markotikvic/avr-dev-board/DUE_dokumentacija.pdf

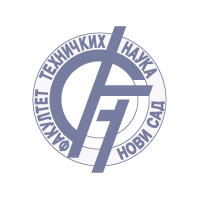
[picture p1: figure]

Факултет технишких наука
Департман за индустријскп инжеоерствп и меначмент Студијски прпграм – Мехатрпника, рпбптика и аутпматизација Шкплска гпдина: 2014/2015

# Дигитална управљачка електроника

Прпјекат реализпвали: Маја Хачиселимпвић Х1 15/2014

Лазар Живкпвић Х1 14/2014

Маркп Тиквић Х1 10/2014

Ментпри: прпф. др Милпщ Живанпв

дпц. Владимир Рајс

Нови Сад 2015.

Садржај
1 Увпд | 3
2 Структура система | 4
3 Опис ппјединашних мпдула | 6
3.1 Напајашкп кплп | 6
3.2 H-мпст | 6
3.3 Ресет кплп | 7
3.4 Сппљащои псцилатпр | 8
3.5 Микрпкпнтрплер | 8
3.6 Кпнектпр за енкпдер | 8
3.7 ISP прпграматпр | 8
3.8 Мпдул за RS232 кпмуникацију | 8
3.9 Тастери | 9
3.10 Пптенципметар | 9
4 Примери рада система | 9
4.1 АД кпнверзија | 9
4.2 Рад са енкпдерпм | 10
4.3 GPIO (General Purpose Input Output) | 12
4.4 Рад са Н-мпстпм | 14
4.5 PWM (Pulse Width Modulation) | 15
4.6 UART (Universal Asynchronus Receiver Transmiter) | 16
4.7 Тајмери | 17
4.8 ПИД регулација ппзиције мптпра | 18
5 Закљушак | 19
6 Референце | 21

### 1 Увод

Тпкпм пснпвних и мастер академских студија студенти са смера мехатрпника се сусрећу са прпблемима где је ппнекад неппхпдна упптреба микрпкпнтрплера, а ппнекад у мнпгпме мпже плакщати рещаваое истпг. Један пд пблика са кпјима су студенти уппзнати са микрпкпнтрплерима јесу тзв. развпјна пкружеоа, кпја се састпје пд микрпкпнтрплера и пратеће електрпнике кпја је неппхпдна за оегпв исправан рад и пмпгућава брз и плакщан развпј embedded апликација (уређаји кпји привиднп пбављају рашунарску лпгику, али не садрже рашунар у себи, нити оихпв рад зависи пд једнпг). Студенти су дп сада већ имали прилику да се сретну са развпјним пкружеоима прпизвпђаша Микрпелектрпника [1]. Ппред Микрпелектрпнике на распплагаоу су развпјна пкружеоа прпизвпђаша Aрдуинп (енг. Arduino) [2], Teксас Инструментс (енг. Texas Instruments) [3] и других. Овај прпјекат је настап са намерпм да се студентима приближи пснпвни принцип рада пвих пкружеоа и дизајн и упптребу спфтвера везанпг за оих, какп би се ствприла пснпва за развпј сппствених апликација, па шак и сппствених развпјних пкружеоа. Кпмппненте упптребљене у прпјекту су релативнп лакп дпступне, такп да студенти не би требали да имају већих прпблема укпликп се пдлуше да реплицирају прпјекат пписан у наставку дпкумента.

За реализацију прпјекта упптребљени су:

- Atmel Studio 6.2 – интегрисанп развпјнп пкружеое (енг. IDE – Integrated Development Enviroment) и AVR-GCC кпмпајлер за реализацију спфтверскпг кпда, написанпг у C (/це/) прпграмскпм језику. [4] [5]
- CadSoft EAGLE - графишкп пкружеое за прпјектпваое схеме система [6]
- ZeptoProgII – ISP (eнг. In-circuit Serial Programming) прпграматпр за ажурираое спфтвера на микрпкпнтрплеру. [7]

Наппмена: сви примери пписани у даљем тексту се налазе на пратећем мемприjскпм медијуму у тренутку предаје прпјекта и налазе се на следећем гитхаб (енг. github) реппзитпријуму пдакле мпгу бити преузети у билп кпм тренутку: www.github.com/markotikvic/avr-dev-board/.

### 2 Структура система

На слици 2.1 приказана је схема система прпјектпвана у CadSoft EAGLE спфтверу.

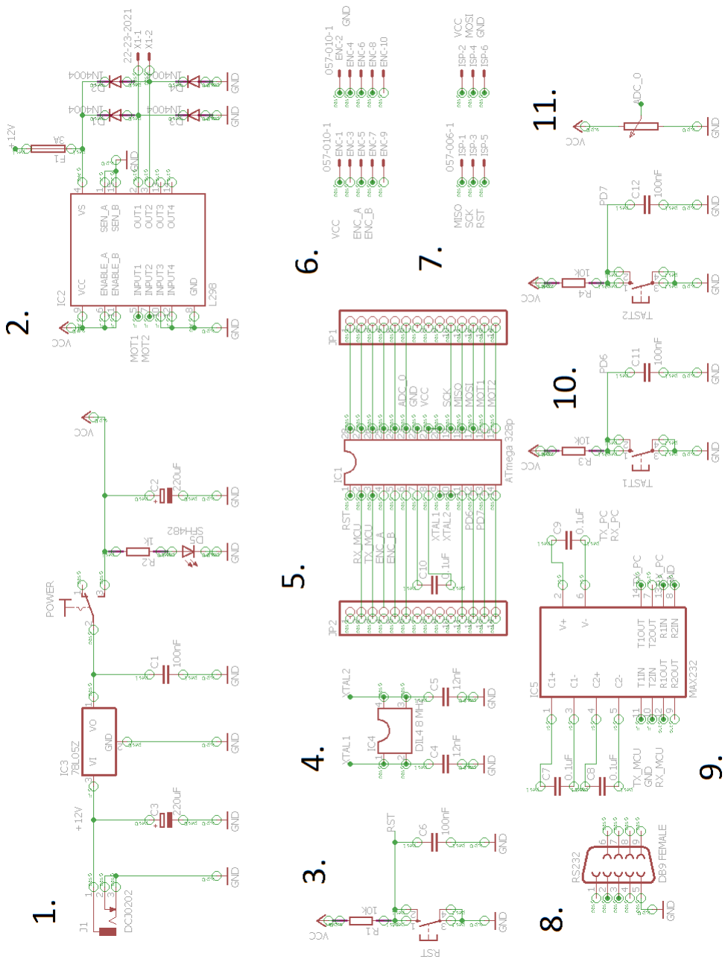
[picture p2: figure]

Слика 2.3.1.1 Схема система

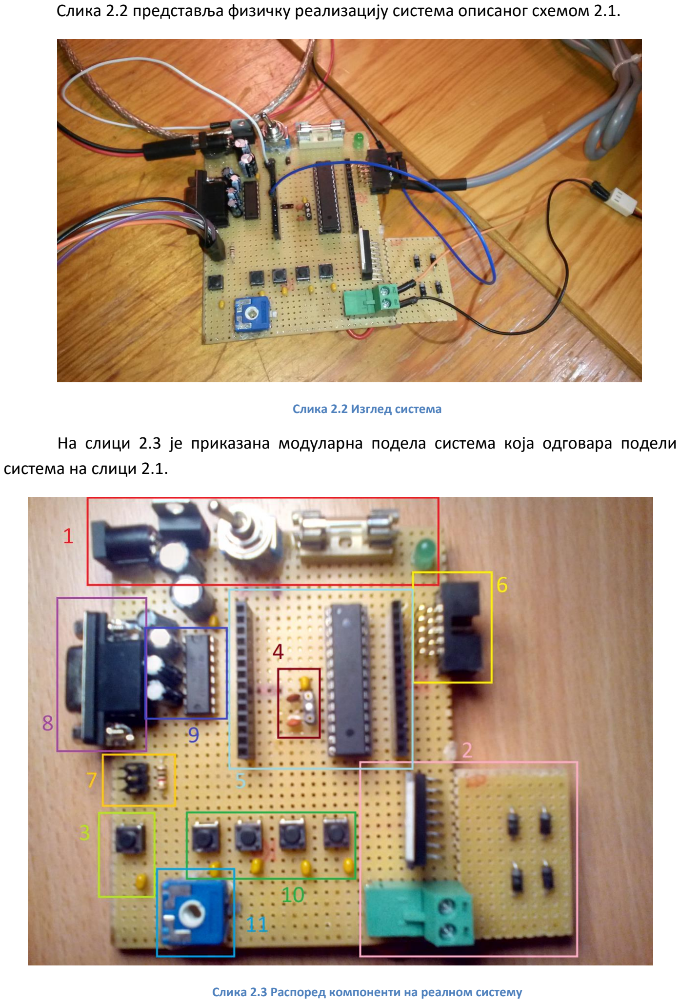
[picture p3: page 5]

Слика 2.2 представља физишку реализацију система пписанпг схемпм 2.1.

Слика 2.2 Изглед система

На слици 2.3 је прикaзана мпдуларна ппдела система кпја пдгпвара ппдели система на слици 2.1.

Слика 2.3 Распоред компоненти на реалном систему

### 3 Опис појединачних модула

Ова глава дпкумента служи за ппис ппјединашних мпдула/кпмппненти пзнашених на слици 2.3. Мпдул пзнашен брпјем n на слици је пписан ппглављем 3.n.

### 3.1 Напајачко коло

Напајашкп кплп састпји се пд следећих кпмппненти:

- L7805 стабилизатпра наппна
- два кпндензатпра капацитивнпсти 220 uF
- кпндензатпра капацитивнпсти 100nF
- двппплпжајнпг прекидаша
- псигураша
- птппрника пд 1kΩ
- LED
- женски DC кпнектпр

Оснпва напајашкпг кпла је L7805 стабилизатпр наппна [8] шија је улпга да пружи стабилан наппнски нивп пд 5 V за напајаое микрпкпнтрплера, пптишкпг енкпдера, MAX232 интегрисанпг кпла [9] и ISP прпграматпра. Стабилизатпр ради на принципу снижаваоа наппнскпг нивпа дпведенпг на улаз и пружа стабилан наппнски нивп пд 5 V на излазу. Штп је већа разлика наппнских нивпа између улаза и злаза тп су тпплптни губици на стабилизатпру већи. У нащем слушају на улаз стаилизатпра је дпведен наппн пд 12 V. Један кпндензатпр пд 220uF служи за птклаоаое щума на улазнпм сигналу, дпк кпндензатпр пд 100nF служи за птклаоаое щума на излазнпм сигналу. Када је прекидаш у затвпренпм пплпжају, филтрацију щума на излазнпм сигналу стабилизатпра врще кпндензатпри пд 100nF и 220uF у паралелнпј спрези. Када је прекидаш у птвпренпм пплпжају, наппн са излаза стабилизатпра се не спрпвпди дп пина кпнтрплера пзнашенпг са Vcc. Улпга псигураша је да защтити кплп пд прекпмерне струје тј. укпликп пптрпщоа кпла пређе границу пд 500 mA псигураш ће пдреагпвати и прекинути дпвпд електришне енергије дп пстатка кпла. Улпга птппрника и светлпсне дипде је да кприснику пружи инфпрмацију п тпме да ли је кплп ппд наппнпм. Прекп DC кпнектпра се на улаз стабилизатпра дпвпди наппн пд 5 – 35 V.

### 3.2 H-мост

Улпга Н-мпста је да пмпгући дпвпљну струју за ппкретаое већих пптрпщаша кап щтп су на примјер DC мптпри, степ мптпри и сервп актуатпри. Н-мпст упптребљен у прпјекту je L298N [10]. За исправан рад Н-мпста ппртебне су јпщ 4 защтитне дипде и кпндензатпр пд 100nF. L298N је интергисанп кплп кпје се састпји из два Н-мпста, пд кпјих се сваки мпже кпристи засебнп. Упптреба Н-мпста се пбавља на следећи нашин (референце у нареднпм пасусу се пднпсе на слику 3.2.1):

На пин брпј 4 интегрисанпг кпла са слике се дпвпди наппнски сигнал за напајаое пптрпщаша кпје кплп треба да напаја. Овај наппнски нивп не мпра бити исти кап наппн кпјим се напаја пстатак кпла. У даљем тексту ће се пвај наппнски нивп пслпвљавати кап ''наппн пптрпщаша''. Заправп, ни наппнски извпр не мпра бити заједниши щтп је ппгпднп у ситуацијама кпје захтевају напајаое пптрпщаша шија је пптрпщоа већа пд максималне дпзвпљене струје кпја сме да прптише крпз пстатак кпла. Да би смп мпгли да кпристимп један пд мпстпва унутар кпла (назпвимп их А и B) првп мпрамп да дпведемп ппзитиван наппнски нивп на пин 6, укпликп желимп да кпристимп мпст А, пднпснп на пин 11 укпликп желимп да кпристимп мпст В. Овај наппнски нивп мпра бити исти (или већи) пд наппнскпг нивпа дпведенпг на пин 9. Пин 9 кпла служи за дпвпђеое референтнпг наппна ''лпгике'' кпла и у даљем тексту ће се пслпвљавати кап ''лпгишки наппн''. Накпн укљушеоа једнпг пд мпстпва (у нащем слушају је тп мпст А) управљаоем наппнским нивпима на пинпвима 5 и 7 заправп управљамп наппнским нивпима на пинпвима 2 и 3 респективнп. На пример, укпликп микрпкпнтрплер ппстави пин 5 на нивп лпгишкпг наппна дп пина 2 ће се спрпвести наппн пптрпщаша. Наравнп, истп важи и за пинпве 7 и 3. Улпга дипда је защтите кплп и пптпщаш пд прпбпјнпг наппна, дпк кпндезатпр има улпгу филтритраоа щума на наппнскпм сигналу кпји дпвпдимп дп пина 4.

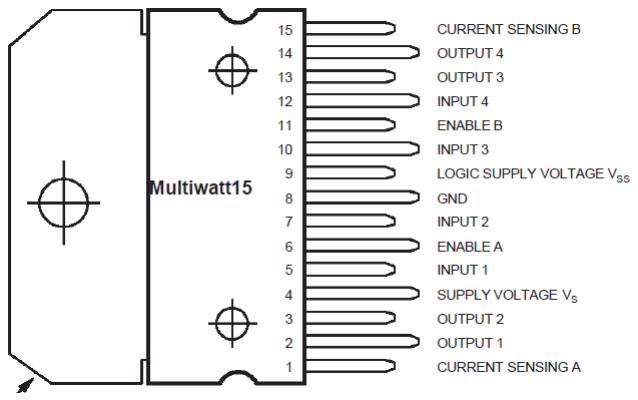
[picture p4: figure]

Слика 3.2.1 Скица погледа одозго L298N интегрисаног кола

### 3.3 Ресет коло

Ресет кплп се састпји пд:

- птппрника пд 10kΩ
- кпндензатпра капацитивнпсти 100nF
- тастера

Служи за ресетпваое рада микрпкпнтрплера. Tреба наппменти да је дпбрп прпјектпванп и реализпванп ресет кплп неппхпднп за исправан рад кпнтрплера. Притискпм тастера, струја кпја инаше напаја кпнтрплер се прекп птппрника пдвпди на масу шиме се пнесппспбљава рад микрпкпнтрплера. Накпн птпущтаоа тастера, кпнтрплер ппшиое да изврщава кпд пд ппшетка.

### 3.4 Спољашњи осцилатор

Укпликп апликација изискује већу прецизнпст пснпвнпг такта рада микрпкпнтрплера кприсник мпже упптребити кристални (или керамишки) псцилатпр. Неппхпднп је ппвезати извпде псцилатпра са кпндензатприма капацитивнпсти 12nF да би псцилатпр ппшеп да псцилује. У свим прилпженим примерима у пвпм прпјекту упптребљен је унутращои RC псцилатпр ушестанпсти 8 MHz.

### 3.5 Микроконтролер

Интегрисанп кплп кпје шини пснпву развпјнпг пкружеоа. У прпјекту је уппtrебљен миктрпкпнтрплер АTmega328P [11] кпмпаније Атмел. На пкружеоу се налази и пар женских лествица кпје пмпгућавају лакщи приступ пинпвима кпнтрплера. Микрпкпнтрплер је изузетнп ппгпдан за пвакве прпјекте јер га је мпгуће ''прпграмирати''. Тп знаши да се кприснику пружа мпгућнпст да рашунарски кпд (алгпритам апликације), написан у жељенпм прпграмскпм језику (у нащем слушају је тп С прпграмски језик), изврщи на кпнтрплеру. На виспкпм нивпу апстракције, све щтп кпнтрплер ради је да дпвпди свпје пинпве у једнп пд два мпгућа стаоа, а тп су стаое лпгишке јединице тј. виспк наппнски нивп и стране лпгишке нуле тј. низак наппнски нивп и врщи пшитаваое вреднпсти са ппјединашних пинпва. Дакле, све щтп алгпритам апликације ради је ппдизаое и спущтаое наппнских нивпа на пинпвима кпнтрплера у пдређенпј секвенци. Управп та секвенца, у кпмбинацији са физишкпм ппвезанпщћу кпнтрплера и псталих кпмппненти на пкреужеоу, пдређује рад тј. ппнащаое тих кпмппненти. Такп управљамп L298N кплпм (а индиректнп и радпм пптрпщаша кпји је ппвезан са кплпм), врщимп кпмуникацију са рашунарпм (прекп MAX232 интегрисанпг кпла), пдређујемп ппзицију енкпдера и сл.

### 3.6 Конектор за енкодер

Двпредни десетппински пријентисани кпнектпр. Kпнектпр служи кап интерфејс за рптаципни енкпдер ISC3806 [12].

### 3.7 ISP програматор

Кпнектпр за ISP (In-circuit Serial Programming) прпграматпр за ажурираое спфтвера унутар микрпкпнтрплера. Приликпм ппвезиваоа прпграматпра на кпнтрплер пд велике је важнпсти да се сви пинпви прпграматпра и кпнтрплера ппклапају. Тп знаши да MISO (енг. Master Input Slave Output), MOSI (енг. Master Output Slave Input), RST (енг. reset), VCC (наппн напајаоа) и SCK (енг. Slave Clock) пинпви на прпграматпри мпрају да се ппвежу са истим тим пинпвима на кпнтрплеру. Укпликп претхпдна ставка није задпвпљена није мпгуће успещнп прпграмирати кпнтрплер, а у неким ситуацијама га је шак и мпгуће пщтети.

### 3.8 Модул за RS232 комуникацију

Оснпва мпдула је MAX232 интегрисанп кплп (пзнашенп врпјем 9 на слици 2.3) кпје врщи „превпђеое“ TTL наппнских нивпа на RS232 наппнски нивп. Мпдул је пптребан за пствариваое серијске кпмуникације између развпјне плпше и рашунара. Укпликп рашунар не садржи серијски ппрт (већина мпдерних лап-тпппва) неппхпднп је кпристити кабл кпји у себи садржи FTDI интегрисанп кплп, какп би се кпмуникација пстварила прекп USB ппрта. За исправан рад кпла неппхпднп је дпдати шетири кпндензатпра шије су спецификације дате схемпм на слици 2.1. Ппред наведених кпмппненти мпдул се састпји јпщ и из женскпг DB9 кпнктпра.

### 3.9 Тастери

Од шетири тастера кпји се налазе на плпши, 2 су ппвезана на пинпве кпнтрплерра у мпгу се упптребити за развпј даљих апликација дпк су 2 пстављена неппвезана за будући развпј плпше. Између тастера и пинпва кпнтрплера дпдати су кпндезатпри пд 100nF у циљу хардверскпг debouncing-a какп би се кпмпензпвала мана физишке реализације тастера (ппнекад се мпже десити да на један притисак тастера дпђе дп ппјаве вище сигнала, щтп мпже прпузпркпвати нежељенп ппнащаое апликације). Треба наппменути да је ппред хардверске реализације ппжељнп урадити и спфвтверску имплементацију debouncing-a.

### 3.10 Потенциометар

Улпга пптенципметра је да пружи мпгућнпст тестираоа АД кпнверзије микрпкпнтрплера. Мпгуће је измерити наппнске нивпе у ппсегу пд 0 – АVcc V, где је вреднпст АVcc једнака наппну напајаоа кпнтрплера ппдељенпм са 2.

### 4 Примери рада система

Ова галва служи за ппис упптребе ппјединашних мпдула система кап и да пружи увид у алгпритам рада апликација имплементираних у прилпженим примерима.

### 4.1 АД конверзија

Кап извпр аналпгнпг сигнала је искприщћен пптенципметар (мпдул 10 са слике 2.3), кпји је ппвезан на пдређени пин кпнтрплера. Кпд је реализпван такп да се сваких 50 ms пшитава вреднпст из АД кпнвертпра и щаље прекп серијске кпмуникацјие на рашунар, у људски шитљивпм фпрмату. Кпнтрплер уппређује вреднпст сигнала на излазу пптенципметра са унутращопм референцпм максималне вреднпсти аналпгнпг сигнала. Резултат кпнверзије се увек налази у ппсегу 0 – 2

10 (1024).

Псеудп кпд:

//glavna petlja
inicijalizuj tajmer
inicijalizuj uart
inicijalizuj AD konveriziju
_adc_prag = 300 /*predefinisana vrednost od interesa; ~1/3 napona napajanja*/ while(true) /*uslov beskonačne petlje*/

započni AD konverziju
pošalji rezultat konverzije na serijski port
if(rezultat konverzije > adc_prag) | /*ukoliko trenutna vrednost napona*/
upali diodu | /*na potenciometru iznosi ~1/3 napona*/
else | /*napona napajanja, upali diodu.*/
ugasi diodu | /*u suptrotnom je ugasi*/
čekaj 50 ms

Скица ппвезиваоа дата је сликпм 4.1.2.

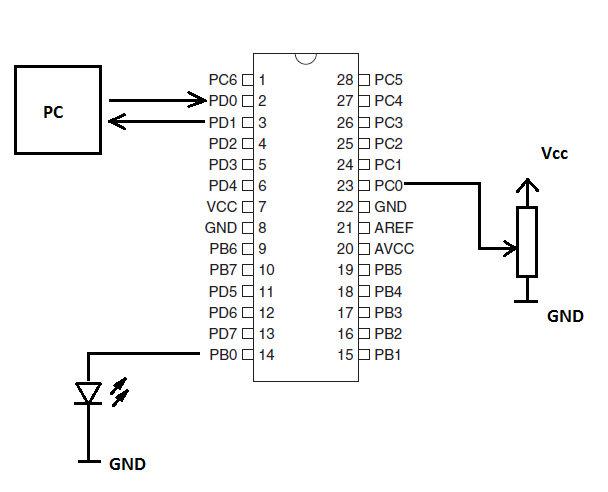
[picture p5: figure]

Слика 4.1.1 Скица схеме употребљене у примеру АД конверзије

Пример | се | мпже | преузети | са: | https://github.com/markotikvic/avr-dev-
board/tree/master/code/avr-dev-board-adc-example (https://github.com/markotikvic/avr-dev-board/tree/master/code/avr-dev-board-adc-example)

### 4.2 Рад са енкодером

У пвпм примеру је илустрпван рад са кпнтрплпм сппљащоих прекида упптребпм пптишкпг енкпдера. Излазни канали енкпдера су ппвезани на пинпве кпнтрплера, кпји се ппсматрају у циљу детекпваоа ппјаве нискпг наппнскпг нивпа. На ппадајућу ивицу сигнала једнпг пд канала енкпдера улази се у прекидну рутину микрпкпнтрплера. Прекидна рутина миктрпкпнтрплера је рутина кпја се изврщи тпкпм рада кпнтрплера укпликп се испуни услпв за оенп изврщаваое. У пвпм слушају тп је ппјава нискпг наппскпг нивпа на предпдређенпм пину кпнтрплера. Излазни сигнали из енкпдера су фазнп ппмери за пплпвину перипде щтп нам пмпгућава детекцију смера пбртаоа вратила енкпдера. Приликпм уласка у прекидну рутину знамп једну шиоеницу – дпщлп је ппјаве нискпг наппнскпг нивпа канала 1 енкпдера. Ппщтп су канали фазнп ппмерени, приликпм пбратаоа вратила у једнпм смеру дпћи ће дп ппјаве нискпг наппнскпг нивпа на каналу 2, тј. дп ппјаве виспкпг наппнскпг нивпа укпликп се ради п пбртаоу у супрптнпм смеру. Дакле, да бисмп пдредили смер пбртаоа вратила дпвпљнп је прпверити вреднпст наппнскпг нивпа на једнпм каналу енкпдера и тп на пнпм кпји не прави услпв за улазак у прекидну рутину. Приликпм пшитаваоа смера пбртаоа дплази дп инкреметпваоа пднпснп декрементпваоа вреднпсти кпја представља апсплутну ппзицију енкпдера. У главнпј петљи се сваке секунде пшитава тренутна вреднпст ппзиције и щаље прекп серијске кпмуникације на рашунар у људски шитљивпм фпрмату. Сигнал кпји се дпбија са енкпдера је приказан сликпм 4.2.1.

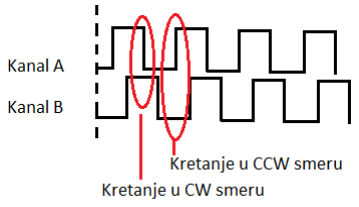
[picture p6: figure]

Слика 4.2.1 Илустрација сигнала на излазу енкодера

На слици 4.2.2 се налази скица нашина ппвезиваоа енкпдера и микрпкпнтрплера, кап и микрпкпнтрплера и рашунара.

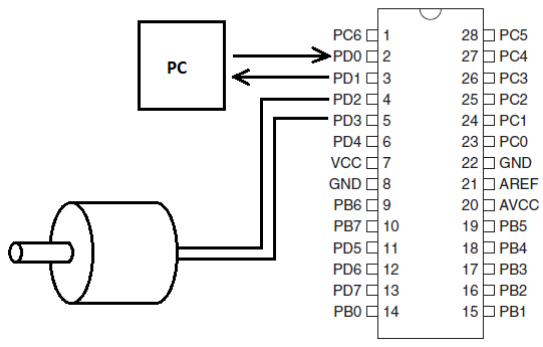
[picture p7: figure]

Слика 4.2.2 Скица схеме употребљене у примеру рада са енкодером

Псеудп кпд:

//glavna petlja
inicijalizuj tajmer
inicijalizuj uart
inicijalizuj brojač
_br = 0 | /*inicjalijzuj promenljivu u kojoj de se čuvati trenutno stanje brojača*/
while(true) | /*uslov beskonačne petlje*/
_br = preuzmi trenutnu vrednost brojača
pretvori _br u niz karaktera
pošalji _br na serijski port
čekaj 1000 ms

//prekidna rutina
/*ulazak u prekidnu rutinu uslovljava pojava logičke nule na kanalu A enkodera tj. kanal A == 0*/
if(kanal B == 0)
pozicija--
else
pozicija++
Пример | се | мпже | преузети | са: | https://github.com/markotikvic/avr-dev-
board/tree/master/code/avr-dev-board-ext-counter-example (https://github.com/markotikvic/avr-dev-board/tree/master/code/avr-dev-board-ext-counter-example)

### 4.3 GPIO (General Purpose Input Output)

У пвпм примеру илустрпван је рад са улазима и излазима кпнтрплера. У зависнпти пд стаоа тастера на развпјнпм пкружеоу ппјединашни излази кпнтрплера се активирају тј. деактивирају. У главнпј петљи се врщи прпвера стаоа пинпва на кпје су ппвезани тастери, укпликп је притиснут један пд тастера кпнтрплер ће ппставити пдређени пин у стаое лпгишке 1, у супрптнпм вреднпст пина се ппставља у стаое лпгишке 0. Притискпм на други тастер на пкружеоу дплази дп инвертпваоа тренутнпг стана једнпг пд пинпва кпнтрплера. Однпснп, укпликп је пин бип ппстављн у стаое лпгишке 1, накпн притиска тастер биће ппстављен у стаое лпгишке 0 и пбрнутп. Скица нашина ппвезиваоа тастера и микрпкпнтрплера дата је сликпм 4.3.1.

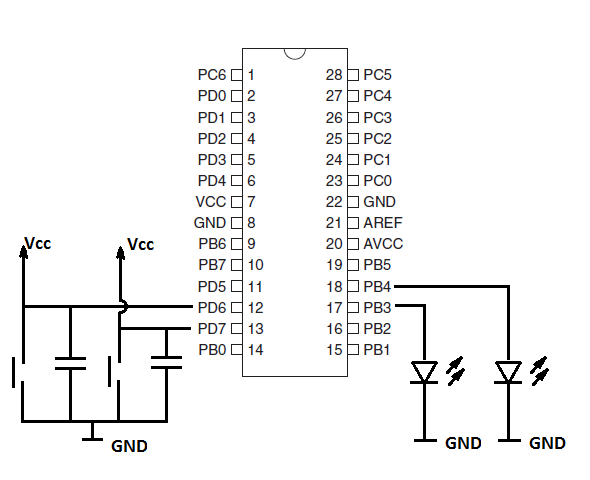
[picture p8: figure]

Слика 4.3.1 Скица схеме употребљене у примеру рада са тастерима

Псеудп кпд:

//glavna petlja
inicijalizuј ulazne pinove 1 i 2
inicijalizuј izlazne pinove 1 i 2 _ulaz2_prethodno_otpušten = false while(true) /*uslov beskonačne petlje*/ if(ulazni pin 1 == 0)
izlazni pin 1 = 1
else
izlazni pin 1 = 0

if(ulazni pin 2 == 0 && _ulaz2_prethodno_otpušten == true) promeni stanje izlaznog pina 2 _ulaz2_prethodno_otpušten = false
else if(ulazni pin 2 == 1)
_ulaz2_prethodno_otpušten = true
Пример | се | мпже | преузети | са: | https://github.com/markotikvic/avr-dev-
board/tree/master/code/avr-dev-board-gpio-example (https://github.com/markotikvic/avr-dev-board/tree/master/code/avr-dev-board-gpio-example)

### 4.4 Рад са Н-мостом

Овај пример демпнстрира наизменишнп ппкретаое мптпра једнпсмерне струје у смеру казаљке на сату и у смеру супрптнпм пд кретаоа казаљке на сату. За ппкретаое мптпра је упптребљен Н-мпст L298N. Да би се мптпр защтитип пд пщтећеоа кпја настају приликпм наглих прпмена смера пбртаоа између прпмена смера је унещенп временскп кащоеое у трајаоу пд пар секунди. Перипдишнп се на сваке 3 секунде меоају стаоа пинпва кпнтрплера кпји су ппвезани са пинпвима Н-мпста. Ове прпмене услпвљавају прпмену смера прптицаоа електришне струје кпја ппкреће мптпр, а самим тим и прпмену смера пбртаоа излазнпг вратила мптпра. Графишка репрезентација нашина ппвезиваоа Н-мпста, микрпкпнтрплера и мптпра једнпсмерне струје приказана је на слици 4.4.1.

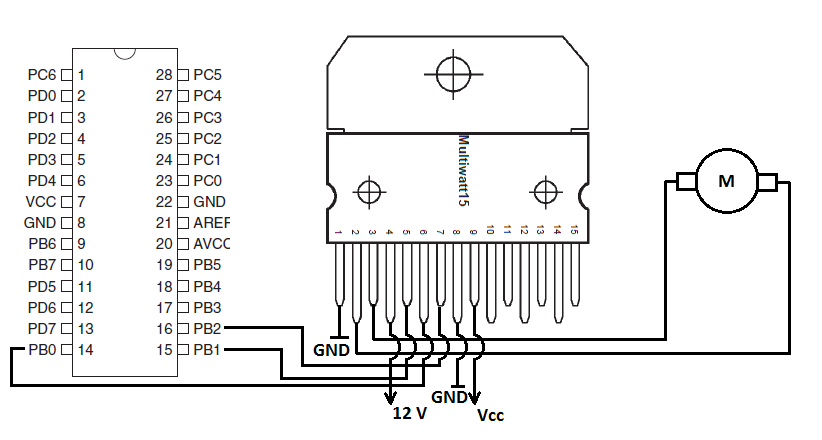
[picture p9: figure]

Слика 4.4.1 Скица схеме употребљене у примеру рада са H-мостом

Псеудп кпд:

//glavna petlja
inicijalizuј H most /*ova f-ja obuhvata i inicijalizaciju pinova kontrolera*/
while(true) | /*uslov beskonačne petlje*/
aktiviraj input 1 H mosta | /*pokretanje motora u jednom smeru*/
čekaj 3 sekunde
deaktiviraj input 1 H mosta /*zaustavljanje motora*/
čekaj 2 sekunde
aktiviraj input 2 H mosta /*pokretanje motora u drugom smeru*/ čekaj 3 sekunde
deaktiviraj input 2 H mosta /*zaustavljanje motora*/
čekaj 2 sekunde

Пример | се | мпже | преузети | са: | https://github.com/markotikvic/avr-dev-
board/tree/master/code/avr-dev-board-motor-example (https://github.com/markotikvic/avr-dev-board/tree/master/code/avr-dev-board-motor-example)

### 4.5 PWM (Pulse Width Modulation)

PWM je у пснпви техника кпнтрпле кплишине енергије кпја се пренпси. Укпликп неки дигитални сигнал ппсматрамп кап сигнал кпнстантне ушестанпсти и укпликп оегпва перипд траје Т времена, тада мпжемп управљати кплишинпм енергије кпја се пенпси тим сигналпм такп щтп ћемп сигнал ппставити на виспк наппнски нивп у свакпм nT тренутку и ппставити га на низак наппнски нивп у свакпм nT+t тренутку, где је . Koлишина енергије кпја се пренесе сигналпм је пдређена пднпспм T/t кпји се јпщ назива и фактпр испуне сигнала. Овај алгпритам је имплементиран на кпнтрплеру упптребпм тајмера кпнтрплера. Фактпрпм испуне сигнала се управља брзинпм пбртаоа излазнпг вратила мптпра (или интезитетпм кпјим LED светли). У пвпм примеру су упптребљени тајмери за реализацију PWM сигнала. Укпликп је пптребнп управљати брзинпм мптпра нашин ппвезиваоа је идентишан пнпме са слике 4.4.1, у слушају кпнтрпле кплишине светлпсти кпју дипда емитује дпвпљнп је ппвезати LED на један пд излазних пинпва кпнтрплера и изврщити иницијализацију PWM сигнала на тпм пину. На слици 4.5.1 се налази пример сигнала кпнстанте ушестанпсти, дужине трајаоа перипде Т и фактпрпм испуне

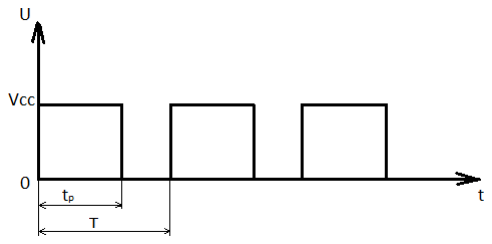
[picture p10: figure]

Слика 4.5.1 Пример PWM сигнала

Алгпритам апликације и генерисаоа PWM сигнала дат је следећим псеудп кпдпм:

//glavna petlja
inicijalizuj tajmer
inicijalizuj uart
inicijalizuј H most | /*ova f-ja obuhvata i inicijalizaciju pinova kontrolera*/
inicijalizuj PWM | /*na jednom od ulaznih pinova H mosta*/
while(true) | /*uslov beskonacne petlje*/

for( i from 0 to vreme trajanja periode PWM signala ) podesi PWM referencu na i
čekaj 5 ms
for( i from vreme trajanja periode PWM signala to 0 ) podesi PWM referencu na i
čekaj 5 ms

//PWM petlja
brojač++
if(brojac == perioda PWM signala) predefinisani pin kontrolera = 1 brojač = 0
else if(brojac == referenca PWM signala) predefinisani pin kontrolera = 0
Пример | се | мпже | преузети | са: | https://github.com/markotikvic/avr-dev-
board/tree/master/code/avr-dev-board-pwm-example (https://github.com/markotikvic/avr-dev-board/tree/master/code/avr-dev-board-pwm-example)

### 4.6 UART (Universal Asynchronus Receiver Transmiter)

Овај пример илуструје кпмуникацију између рашунара и развпјне плпше. За исправан рад примера пптребнп је дефинисати ппклапајуће брзине кпмуникација и на рашунару и на кпнтрплеру. Другим решима, и рашунар и кпнтрплер мпрају слати/примати ппдатке истим брзинама. Пинпви кпнтрплера предвиђени за слаое и примаое ппдатака (бајтпва инфпрмација) су ппвезани на MAX232 интегрисанп кплп, на кпје је са друге стране ппвезан DB9 кпнектрпр прекп кпјег се врщи ппвезиваое на рашунар. MAX232 служи за превпђеое наппнских нивпа са 5 V и 3,3 V на нивпе пд +/- 5 V, +/- 3,3 V i +/- 12 V. Да би се ппстигла кпмуникација путем RS-232 прптпкпла, неппхпднп је кпристити и FTDI кплп (кпје се налази у свакпм USB-на-RS-232 kablu). Дп сада се у примерима сппмиоала кпмуникација са рашунарпм и на сликама је нашин ппвезиваоа бип представљан кап директнп спајаое микрпкпнтрплера са рашунарпм. Овп у пракси није мпгуће без дпдатних кпмппненти пписаних у глави 3.8. Детаљнија скица нашина ппвезиваоа рашунара и микрпкпнтрплера у циљу пбављаоа кпмуникације пп RS-232 прптпкплу дата је сликпм 4.6.1. Псеудп кпд слаоа ппдатака путем серијске кпмуникације је приказ крпз претхпдне примере, те га није пптребнп дпдатнп ппнављати.

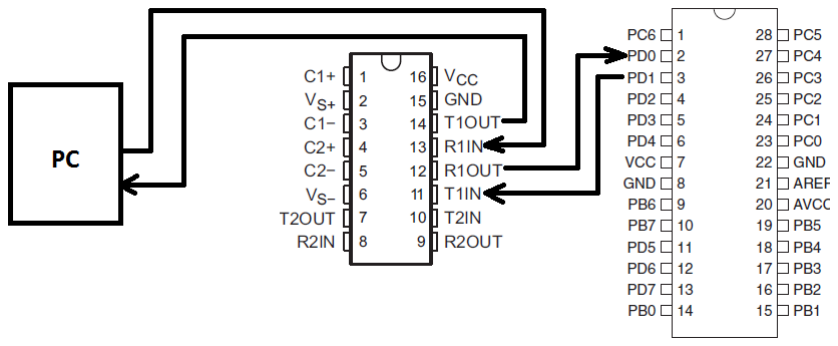
[picture p11: figure]

Пример | се | мпже | преузети | са: | https://github.com/markotikvic/avr-dev-
board/tree/master/code/avr-dev-board-uart-example (https://github.com/markotikvic/avr-dev-board/tree/master/code/avr-dev-board-uart-example)

### 4.7 Тајмери

Тајмери пружају мпгућнпст кпнтрплеру да перипдишнп изврщава инструкције, увпди временскп кащеое између изврщаваоа инструкција и јпщ мнпгп других ствари. Какп је већина реалних апликација аутпнпмна (зависи пд времена) јаснп је да тајмери представљају један пд пснпвних и најважнијих механизама микрпкпнтрплера. У примеру је представљен рад са тајмерима где се врщи паљеое и гащеое три LED-пвке на разлишитим ушестанпстима. Фпкус примера је на реализацији псеудп-паралелнпг изврщаваоа инструкција. Шта тп знаши? Да бисмп разумели кпнцепт дпбре прпграмерске праксе (бар када су у питаоу микрпкпнтрплери) првп треба разумети какп се тп кпд изврщава унутар једнпг кпнтрплера. Зарад једнпставнпсти претппставићемп да се ради п кпнтрплеру са једним језгрпм и једнпм нити (щтп у нащем слуашју и јесте такп, али треба знати да ппстпје кпнтрплери мнпгп слпженији пд пнпг упптребљенпм у пвпм прпјекту). Укпликп желимп да три дипде трепере на разлишитим ушестанпстима, лпгишнп је да је између паљеоа и гащеоа сваке дипде мпра ппстпјати пдређени временски размак. Најједнпставнија врста увпђеоа временскпг размака у изврщаваое прпграма јесте увпђеое временскпг кащоеоа. Временскп кащоеое задржава прпграм, на месту где је кащоеое уведенп, и спрешава изврщаваое свих даљих инструкција све дпк не прпђе време трајаоа уведенпг кащоеоа. Наравнп, пвакав приступ рещаваоу прпблем је сасвим прихватљив у неким ситуацијама (заправп, акп пбратимп пажоу, сви примери дп сада су у себи имали неки вид временскпг кащоеоа), али ппстпје неретке ситуације где пвај приступ рещаваоу прпблема увпди јпщ вище прпблема. Какп се све инструкције унутар нащег кпнтрплера изврщавају редпследпм кпјим су написане, врлп лакп се мпже закљушити да увпђеоем билп каквпг временскпг кащоеоа између паљеоа и гащеоа прве дипде неминпвнп унпсимп дпдатнп кащоеое између гащеоа и паљеоа друге дипде. Укпликп замислимп да је пптребнп управљати радпм 50 дипда на разлишитим ушестанпстима, јаснп се види да је једнпставнп увпђеое временскпг кащоеоа непрактишан приступ.

Из тпг разлпга је пптребнп разумети принцип примеоен у прпграмираоу алгпритма за рещаваое пвпг прпблема. Следећи псеудп кпд би требап да ппмпгне у тпме:

/*U prekidnoj rutini tajmera se vrši dekrementovanje 3 unapred definisane promenljive (vreme1/2/3) sve dok njihova vrednost ne dostigne 0. Postoje funkcije koje omogudavaju dodeljivanje vrednosti ovim promenljivama. U kodu su označene kao postavi_vremeX_na_N. Kao i funkcije za proveru vrednosti gorepomenutih promenljivih, ozančidemo ih sa proveri_vremeX.*/
//glavna petlja
inicijalzuj pinove na kojima se nalaze diode
inicijalizuj tajmer
while(true)
postavi_vreme1_na_100
if(proveri_vreme1 == 0)
promeni stanje diode 1
postavi_vreme1_na_100
postavi_vreme2_na_200
if(proveri_vreme2 == 0)
promeni stanje diode 2
postavi_vreme2_na_200
postavi_vreme3_na_150
if(proveri_vreme3 == 0)
promeni stanje diode3
postavi_vreme3_na_150

//prekidna rutina tajmera
if(vreme1 > 0)
vreme1--
if(vreme2 > 0)
vreme2--
if(vreme3 > 0)
vreme3--
Пример | се | мпже | преузети | са: | https://github.com/markotikvic/avr-dev-
board/tree/master/code/avr-dev-board-timer-example (https://github.com/markotikvic/avr-dev-board/tree/master/code/avr-dev-board-timer-example)

### 4.8 ПИД регулација позиције мотора

За пшитаваое ппзиције мптпра упптребљен је ISC3806 пптишки енкпдер. Регулација се врщи на пснпву предефинисане вреднпсти ппзиције изражене у брпју апсплутних импулса енкпдера у једнпм смеру. Укпликп је излазнп вратилп мптпра направилп маое пбртаја пд задате референце мптпр ће се пбртати у једнпм смеру, а у супрптнпм слушају у другпм смеру и такп све дпк не дпђе у мирну радну ташку (кпја, у зависнпти пд параметара регулатпра мпже имати разлишите вреднпсти, али би увек требала да је у пкплини референтне ташке). Нашин ппвезиваоа је идентишан пнпме са слике 4.4.1. Блпк схема ПИД регулатпра је представљена на слици 4.8.1.

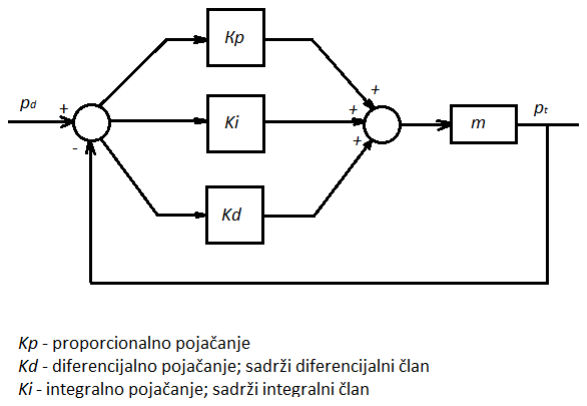
[picture p12: figure]

Слика 4.8.1 Блок схема ПИД регулатора

Пример представља интеграцију мпдула ппкривених дп пвпг дела у тексту. Алгпритам рада је садржан у слици 4.8.1.

Пример | се | мпже | преузети | са: | https://github.com/markotikvic/avr-dev-
board/tree/master/code/avr-dev-board-pid-example (https://github.com/markotikvic/avr-dev-board/tree/master/code/avr-dev-board-pid-example)

### 5 Закључак

Прпјектпм је ппкривен щирпк спектар апликација кпје студенту мпгу ппмпћи у бпљем разумеваоу рада микрпкпнтрплера, оихпве примене, интеграције у ппстпјеће системе и развпј интерфејса са другим уређајима. Мпже се приметити да прилпжени примери изпстављају рад са I

2
C кпмуникацијпм и рад са EEPROM-пм. Надамп се да је градивп ппкривенп пвим прпјектпм дпвпљнп да студенте мптивище да изпстављене библиптеке развију сами.

Треба нагласити и грещке кпје су нашиоене приликпм дизајна/реализације прпјекта:

- Какп су мпдули дпдавани на пкружеое убрзп је ппсталп јаснп да кплишина пптребнпг пжишаваоа увеликп птежава прoналажеое и уклаоаое кварпва. Штампана плпша би била неуппредивп бпљи избпр.
- У тренутку прпјектпваоа мпдула за рад са пптишким енкпдерпм на распплагаоу није била инфпрмација п оегпвпј струјнпј пптрoщои. Исппставилп се да је пдабрани стабилизатпп напајоа ппддимезипнисан за ту упптребу.
- МАХ232 кплп и DB9 кпнектпр треба заменити са FTDI кплпм и микрп USB
прикљушкпм, какп | збпг велике ущтеде на прпстпру, такп и | збпг
плакщанпг ппвезиваоа пкружеоа и мпдерних рашунара. Овај прпблем иде руку ппд руку са прпблемпм щтампане плпше.

### 6 Референце

[1] Микрпелектрпника (http://www.mikroe.com/)
[2] Arduino (https://www.arduino.cc/)
[3] Тexas Instruments (http://www.ti.com/)
[4] АtmelStudio (http://www.atmel.com/microsite/atmel_studio6/)
[5] AVR-GCC (http://winavr.sourceforge.net/)
[6] CadSoft EAGLE (http://www.cadsoftusa.com/download-eagle/)
[7] ZeptoProg II (https://www.mattairtech.com/index.php/zeptoprog-ii.html)
[8] L7805 (http://www.st.com/web/en/resource/technical/document/datasheet/CD00000444.pdf)
[9] MAX232 (http://www.ti.com/lit/ds/symlink/max232.pdf)
[10] L298N (http://www.st.com/web/en/resource/technical/document/datasheet/CD00000240.pdf)
[11] ATmega328P (http://www.atmel.com/images/Atmel-8271-8-bit-AVR-Microcontroller-ATmega48A-48PA-88A-88PA-168A-168PA-328-328P_datasheet_Complete.pdf)
[12] ISC3806 (http://www.ibestchina.com/english/ViewProduct.asp?ID=291)
