markotikvic/avr-dev-board/eagle-files/images/pcb.png

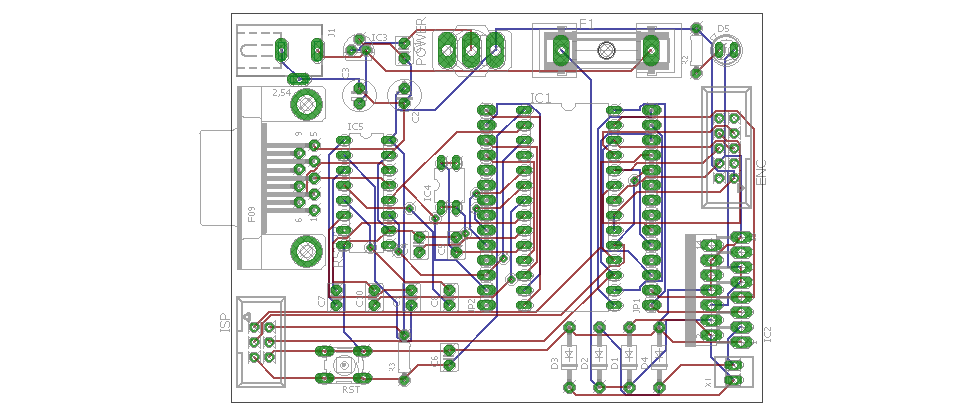
eagle-files/images/pcb.png
