markotikvic/avr-dev-board/eagle-files/images/shema.png

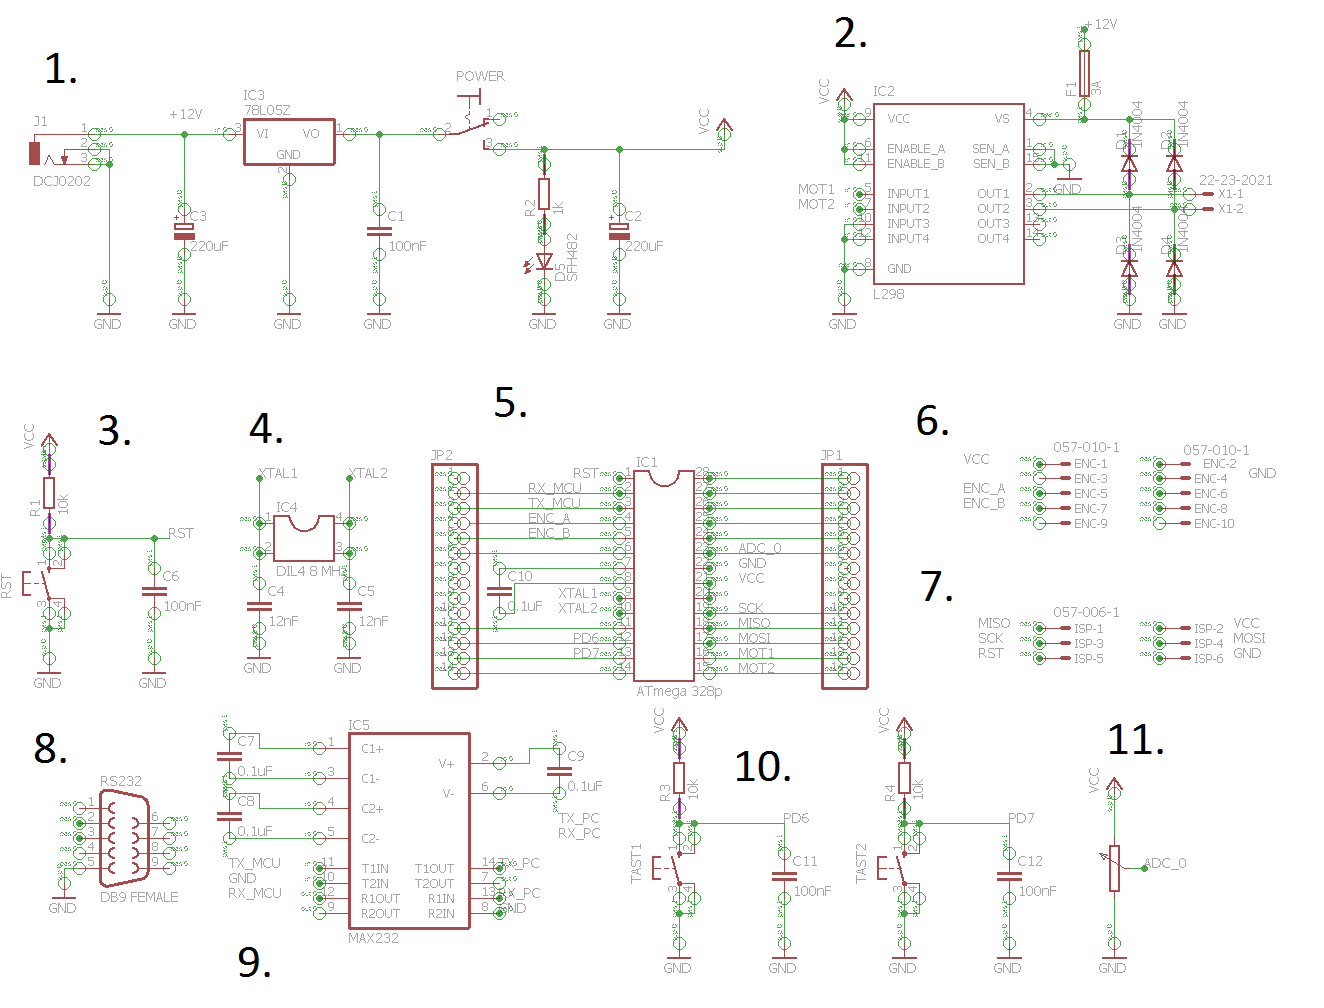
eagle-files/images/shema.png
