markotikvic/avr-dev-board/eagle-files/Board/pid_projekat.brd

## EAGLE design eagle-files/Board/pid_projekat.brd (2015-09-21)

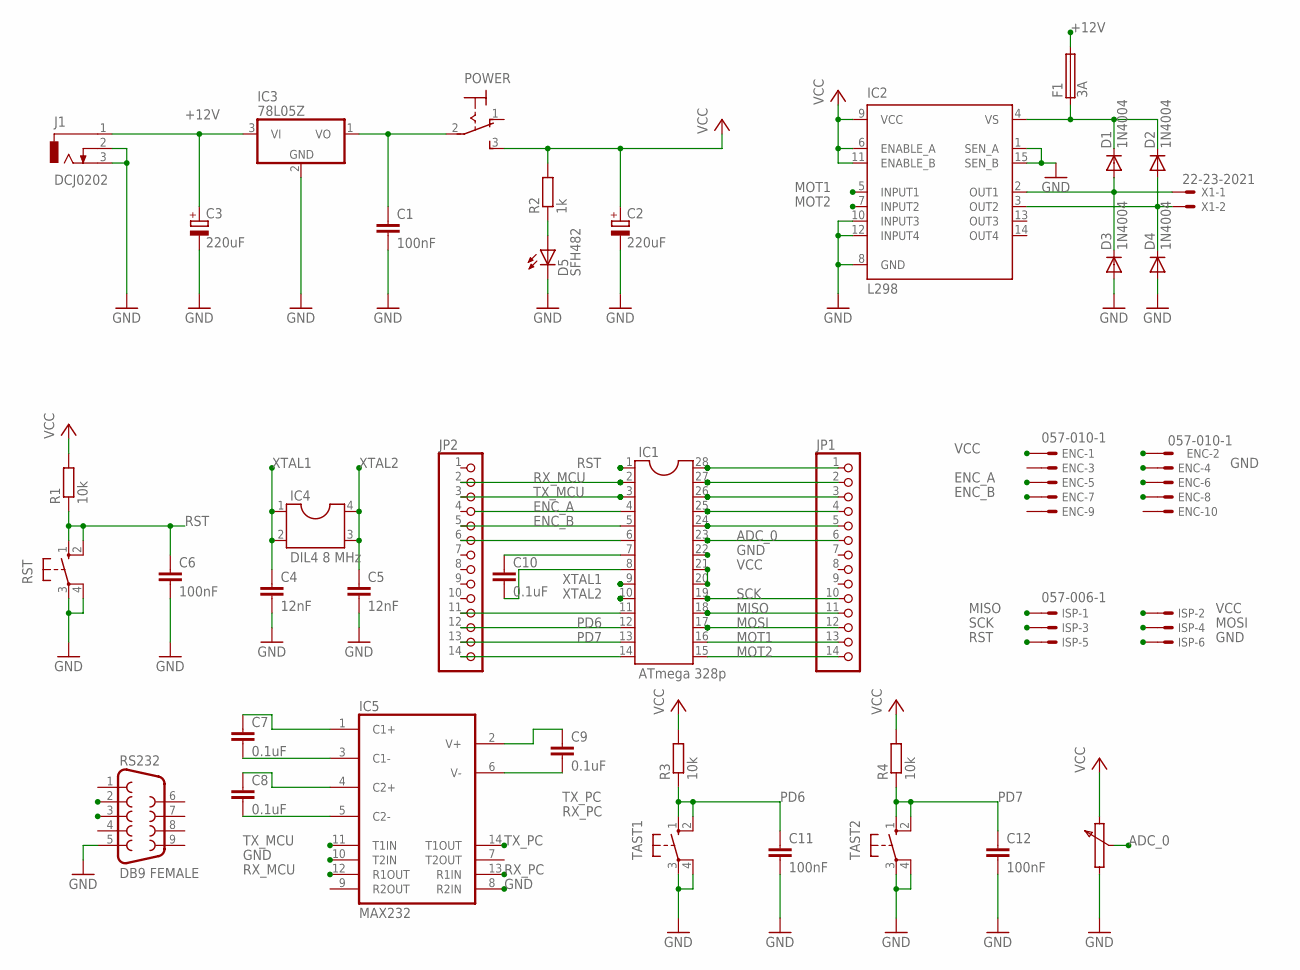
[picture p15: schematic pid_projekat.sch]

Parts:
C1, C6, C11, C12: 100nF; C2.5-3
C2, C3: 220uF; E2,5-6E
C4, C5: 12nF; C2.5-3
C7, C8, C9, C10: 0.1uF; C2.5-3
D1, D2, D3, D4: 1N4004; DO41-10
D5: SFH482
ENC: 057-010-1
F1: 3A; GSH15
IC1: ATmega 328p; DIL28-6
IC2: L298; MULTIWATT-15
IC3: 78L05Z; TO92
IC4: DIL4 8 MHz; DIL04
IC5: MAX232; DIL16
ISP: 057-006-1
J1: DCJ0202
JP1, JP2: PINHD-1X14; 1X14
POWER: 320-916
R1, R3, R4: 10k; 0204/7
R2: 1k; 0204/7
RS232: DB9 FEMALE; F09HP
RST: 10-XX; B3F-10XX
TAST1, TAST2: 10-XX; B3F-10XX
X1: 22-23-2021

Connections:
+12V: C3.+, F1.2, IC3.3 (VI), J1.1
ADC_0: IC1.23, JP1.6
ENC_A: ENC.5, IC1.4, IC1.26, JP1.3
ENC_AINV: ENC.6, IC1.24, JP1.5
ENC_B: ENC.7, IC1.5, IC1.25, JP1.4, JP2.5
ENC_BINV: ENC.8
GND: C1.2, C2.-, C3.-, C4.2, C5.2, C6.2, C11.2, C12.2, D3.A, D4.A, D5.K (C), ENC.4, IC1.22, IC2.1 (SEN_A), IC2.8 (GND), IC2.10 (INPUT3), IC2.12 (INPUT4), IC2.15 (SEN_B), IC3.2 (GND), IC5.8 (R2IN), IC5.10 (T2IN), IC5.15 (GND), ISP.6, J1.2, J1.3, RS232.5, RST.3, RST.4 (P1), TAST1.3, TAST1.4 (P1), TAST2.3, TAST2.4 (P1)
MISO: IC1.18, ISP.1, JP1.11
MOSI: IC1.17, ISP.4, JP1.12
MOT1: IC1.16, IC1.28, IC2.5 (INPUT1), JP1.1, JP1.13
MOT2: IC1.15, IC1.27, IC2.7 (INPUT2), JP1.2, JP1.14
MOT+: D1.A, D3.C, IC2.2 (OUT1), X1.1
MOT-: D2.A, D4.C, IC2.3 (OUT2), X1.2
unnamed: C9.2, IC5.6 (V-)
unnamed: C9.1, IC5.2 (V+)
unnamed: C1.1, IC3.1 (VO), POWER.2
unnamed: D5.A, R2.1
unnamed: IC1.6, JP2.6
unnamed: C7.2, IC5.3 (C1-)
unnamed: C7.1, IC5.1 (C1+)
unnamed: IC1.11, JP2.11
unnamed: C8.1, IC5.4 (C2+)
unnamed: C8.2, IC5.5 (C2-)
unnamed: IC1.14, JP2.14
unnamed: C10.1, IC1.7
unnamed: C10.2, IC1.8
PD6: C11.1, IC1.12, JP2.12, R3.1, TAST1.1 (S), TAST1.2 (S1)
PD7: C12.1, IC1.13, JP2.13, R4.1, TAST2.1 (S), TAST2.2 (S1)
RST: C6.1, IC1.1, ISP.5, R1.1, RST.1 (S), RST.2 (S1)
RX_MCU: IC1.2, IC5.12 (R1OUT), JP2.2
RX_PC: IC5.13 (R1IN), RS232.3
SCK: IC1.19, ISP.3, JP1.10
TX_MCU: IC1.3, IC5.11 (T1IN), JP2.3
TX_PC: IC5.14 (T1OUT), RS232.2
VCC: C2.+, ENC.1, IC1.20, IC1.21, IC2.6 (ENABLE_A), IC2.9 (VCC), IC2.11 (ENABLE_B), IC5.16 (VCC), ISP.2, POWER.3 (S), R1.2, R2.2, R3.2, R4.2
VS: D1.C, D2.C, F1.1, IC2.4 (VS)
XTAL1: C4.1, IC1.9, IC4.1, IC4.2
XTAL2: C5.1, IC1.10, IC4.3, IC4.4

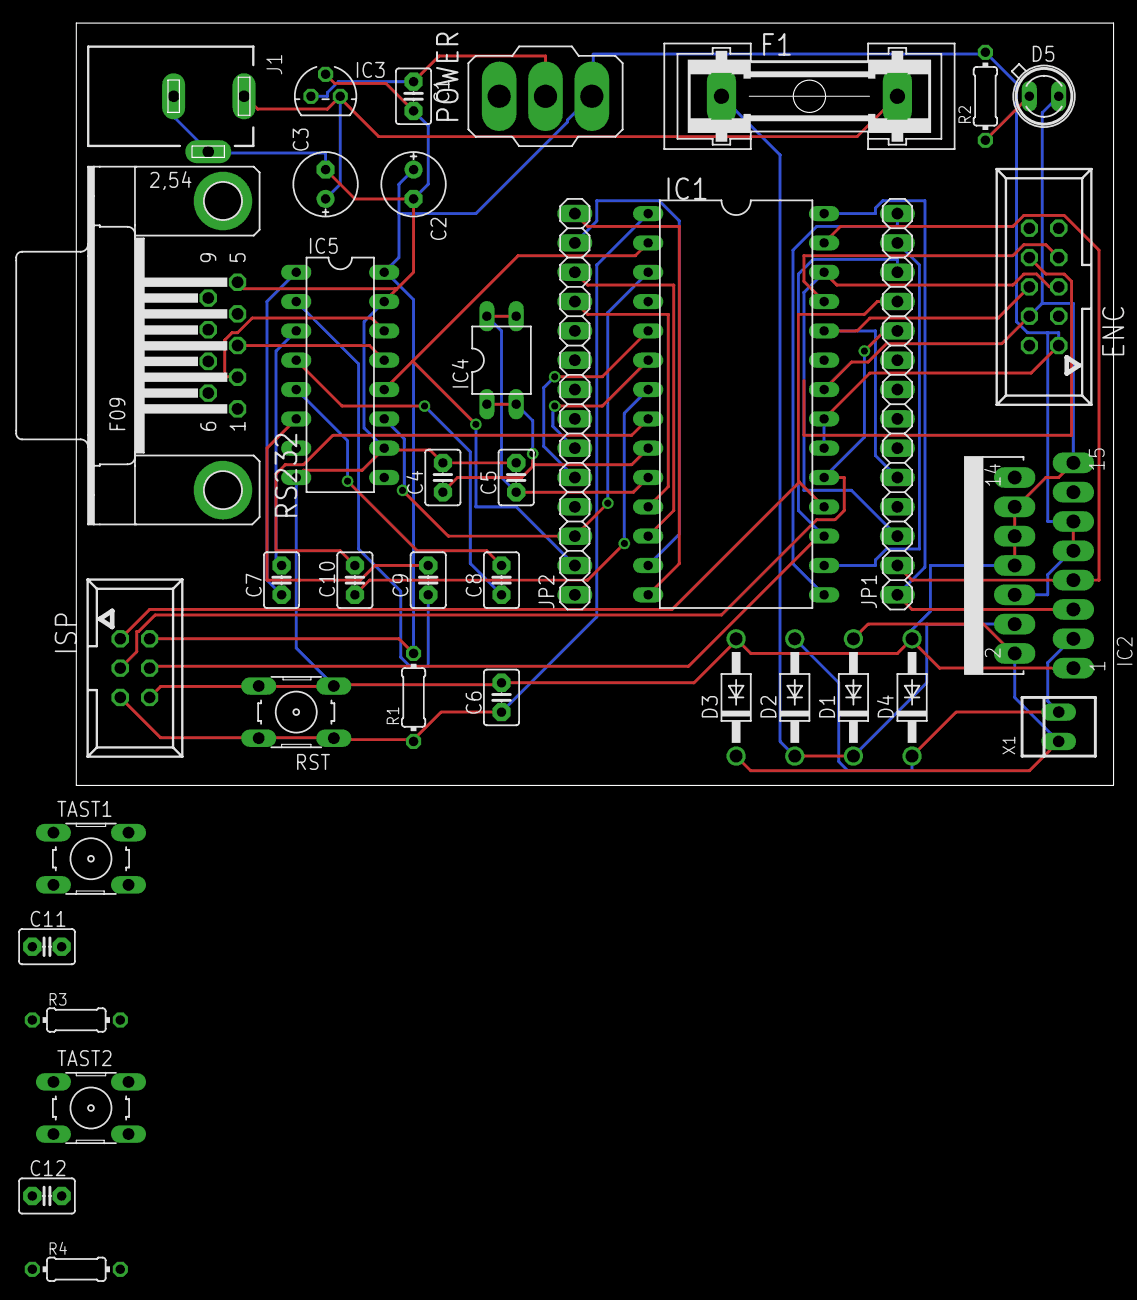
[picture p16: board pid_projekat.brd from above]

Board: 2 copper layers, 89.8 x 66.0 mm, 38 parts (0 on the bottom side), 37 nets.
