markotikvic/avr-dev-board/(commit log)

2015-09-02 Refactored all functions and variables. Unpoluted static variables. Added function poor faster pin write
2015-09-10 убачен пример за серијску комуникацију
    измењена уарт библиотека
    [TcfTransactionLog.csv]
2015-09-10 gpio_doc; separted motor functions
2015-09-10 finished motor example
2015-09-10 pwm example, missing doc
    [adc.c, adc.h, avr-dev-board-pwm-example.c, counter.c, counter.h, globals.h, gpio.c, gpio.h]
2015-09-12 pwm example done
2015-09-12 probano na motorima
2015-09-12 pwm tested with motor
2015-09-13 positional pid done
    [pid_projekat.brd, pid_projekat.sch]
2015-09-13 All done but ADC example
2015-09-13 pid documentation
2015-09-13 updated pid lib in avr_dev_board
2015-09-13 adc example done
2015-09-15 final touches
    [TcfTransactionLog.csv]
2015-09-21 21-09-2015 backup
    [pid_projekat.brd, pid_projekat.sch]
